gontzalarregiaranoa/GrAL_IE_Gontzal/GrAL/acronyms.tex

%*******************************************************
% Acronyms
%*******************************************************
\section*{Akronimoak}

% if withpage option is enabled add following parameters 
% to control vertical space
% \begin{acronym}\addtolength{\itemsep}{-\baselineskip}

% [ABCDE] longest acronym to align left full names of acronyms
\vspace{1cm}

\begin{acronym}   %\itemsep=-10pt
    
    \acro{GrAL}{Gradu Amaierako Lan}
    \acro{LoRa}{\textit{Long Range}}
    \acro{IoT}{\textit{Internet of Things}}
    \acro{MQTT}{\textit{Message Queuing Telemetry Transport}}
    \acro{IDE}{\textit{Integrated Development Environment}}
    \acro{WHO}{\textit{World Health Organization}}
    \acro{PM}{\textit{Materia Partikulatua (Particulate Matter)}}
    \acro{RH}{\textit{Hezetasun Erlatiboa (Relative Humidity)}}
    \acro{WSL}{\textit{Windows Subsystem for Linux}}
    \acro{NTC}{\textit{Thermally Sensitive Resistor with Negative Temperature Coefficient}}
    \acro{Li-Po}{\textit{Lithium-Ion Polymer Battery}}
    \acro{LCD}{\textit{Liquid Crystal Display}}   
    \acro{I2C}{\textit{Inter-Integrated Circuit}}
    \acro{SDA}{\textit{Serial Data}}
    \acro{SCL}{\textit{Serial Clock}}
    \acro{CSS}{\textit{Chirp Spread Spectrum}}
    \acro{LoRaWAN}{\textit{Low Power Wide Area Network}}
    \acro{M2M}{\textit{Machine to Machine}}

\end{acronym}
