gontzalarregiaranoa/GrAL_IE_Gontzal/datuak/proba-kokapena_Zamudio.jpg

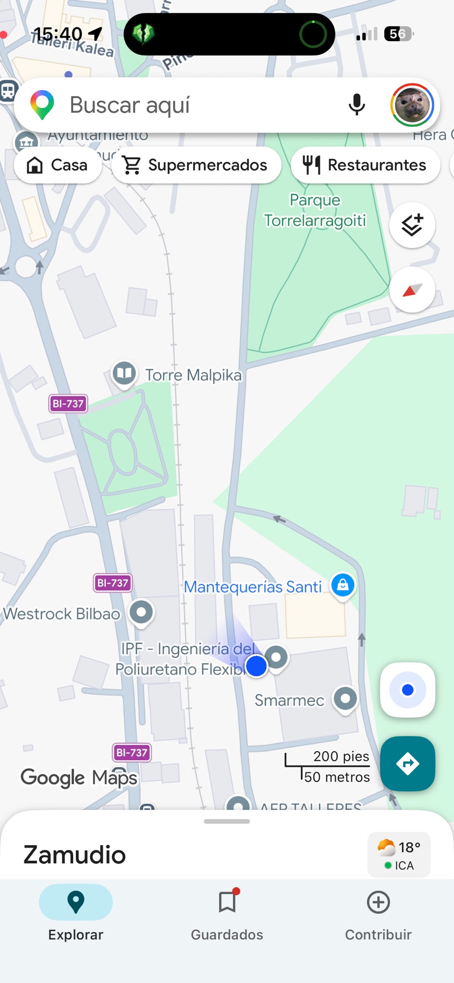
datuak/proba-kokapena_Zamudio.jpg
