gontzalarregiaranoa/GrAL_IE_Gontzal/GrAL/Irudiak/IoT_Arkitektura_Finala.png

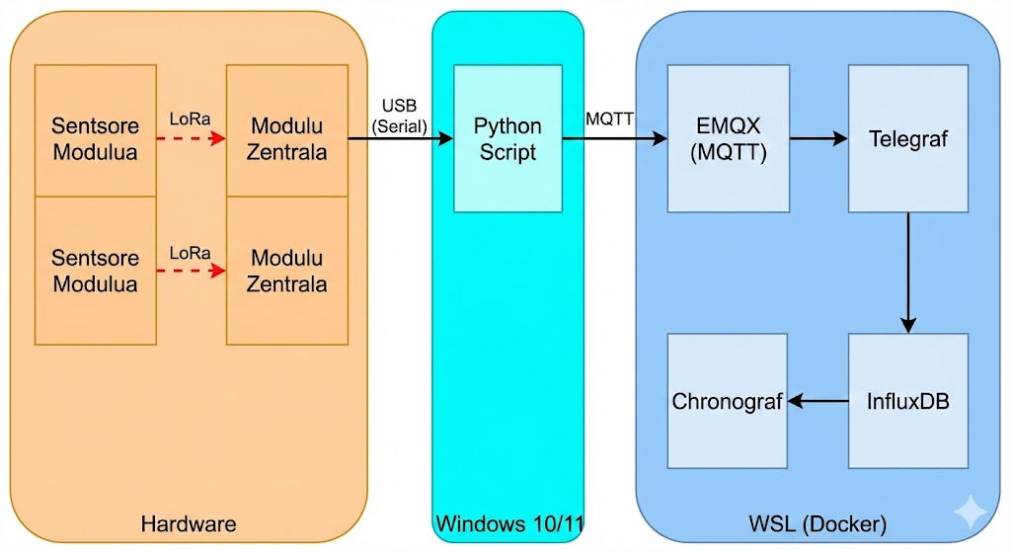
GrAL/Irudiak/IoT_Arkitektura_Finala.png
