gontzalarregiaranoa/GrAL_IE_Gontzal/(commit log)

2026-06-09 TFG: red de sensores LoRa para calidad del aire (GrAL)
    Sistema de monitorizacion ambiental basado en LoRa (Arduino MKR WAN 1310) con pila IoT (MQTT + Telegraf + InfluxDB sobre Docker).
    Incluye: firmware Arduino (modulo sensor, modulo central, pasarela Python), sketches de la prueba de alcance (LoRa.h y RadioLib SF7/SF12), memoria LaTeX (GrAL/) con la prueba de alcance documentada, README y .gitignore.
2026-06-09 Irismen-proba: leyenda de la grafica RSSI/SNR fuera de los ejes
    La leyenda de zonas tapaba la parte baja del grafico RSSI; ahora va debajo de ambos subplots, sin solapar datos.
2026-06-09 Irismen-proba: etiqueta de sensibilidad legible en la grafica RSSI/SNR
2026-06-09 Integrar mejor: conclusiones con alcance/RadioLib + referencias formales
    - Ondorioak: parrafo nuevo con el resultado de alcance (~450 m, LOS como factor critico) y la migracion a RadioLib.
    - Referencias: RadioLib [arduinolora], LoRa.h y datasheet SX1276 citados con \cite (sustituida la nota al pie).
    - Datasheet-ak: anadidas RadioLib y Arduino-LoRa al software, y el datasheet del SX1276.
2026-06-10 Fix beacon RadioLib: transmit() requiere String& (variable con nombre, no temporal)
    [beacon_nodo_radiolib.ino]
2026-06-10 Resultados SF12 (RadioLib): mapa comparativo, grafica RSSI/SNR y tabla
    Historico completo (145 paquetes, P10-228). SF12 alcanza ~775 m (vs 450 m de SF7), RSSI hasta -140 dBm (bajo el suelo nominal de -137) y SNR -20 dB, manteniendo el enlace. Mapa combinado SF7 vs SF12 + grafica RSSI/SNR vs paquete + tabla georreferenciada + analisis.
2026-06-10 Anadir oro2.docx (datos crudos de la prueba de alcance SF12)
2026-06-10 Limpieza: quitar arduino-LoRa-master.zip (dependencia descargable)
    Tambien eliminados localmente GrAL.zip y GrAL_Gontzal_Arregi.pdf (gitignorados, regenerables).
2026-06-10 Reorganizar ARDUINO en firmware/, irismen_proba/ y probak/
    - firmware/: modulo central, modulo sensor, pasarela python
    - irismen_proba/ (antes PRUEBA_ALCANCE): sketches de alcance LoRa.h y RadioLib
    - probak/: sketches de pruebas previas (emisor, receptor, MQ135, display, sensors)
    - README actualizado con la nueva estructura
2026-06-10 Anadir enlace al repositorio GitHub en la introduccion
2026-06-10 Kodea ingelesera eta iruzkinak/dokumentazioa euskerara itzuli
    - README.md osoa euskeraz.
    - Firmware eta proba-sketch guztiak: identifikadoreak ingelesez, iruzkinak eta mezuak euskeraz (sentsore/zentrala, irismen_proba, probak).
    - arduinopython.py: iruzkinak eta mezuak euskeraz.
    - main.tex: RadioLib kode-zerrendako iruzkinak euskeraz (estado -> state).
    - 12. Irudia (IoT arkitektura hibridoa) TikZ diagrama gisa birsortu, PNG akastuna ordezkatuz (sentsore->zentrala bikoiztua zuena).
